galenweld/smart-bag/poster/seal.png

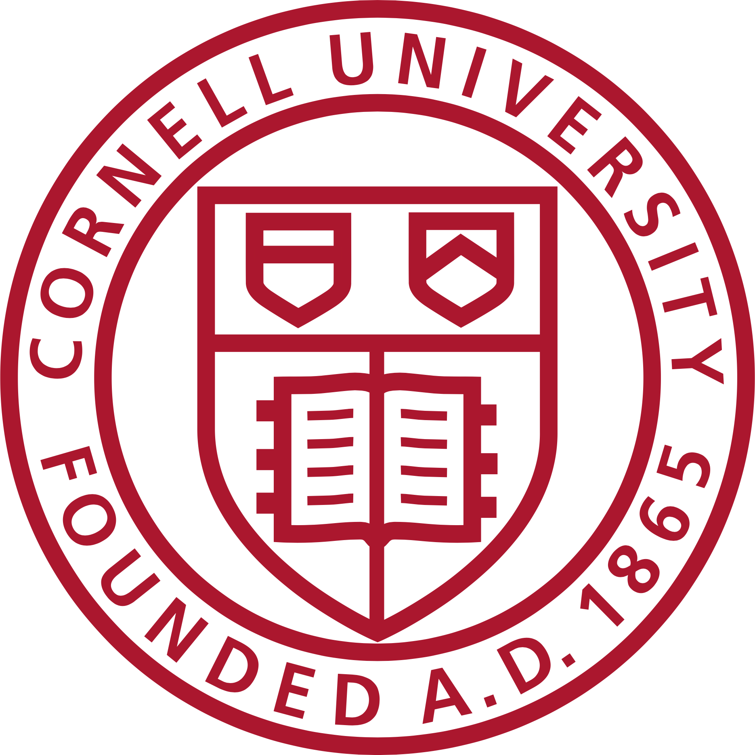
poster/seal.png
