galenweld/smart-bag/writeup/lcd.jpg

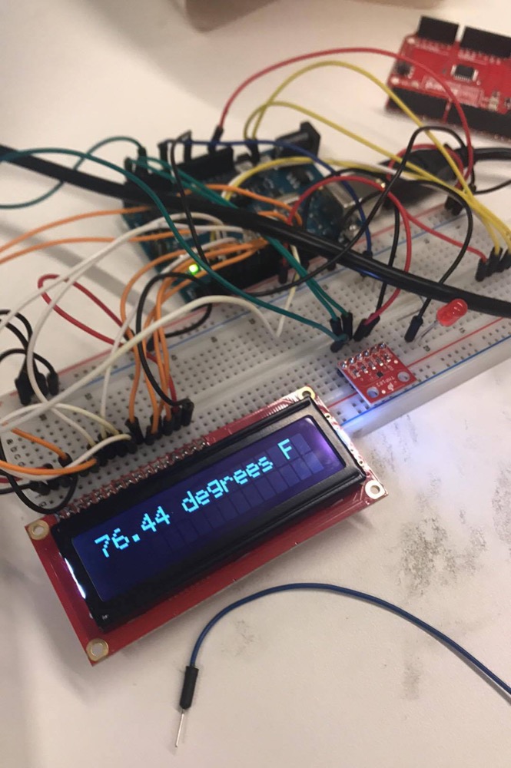
writeup/lcd.jpg
