galenweld/smart-bag/writeup/wiring.jpg

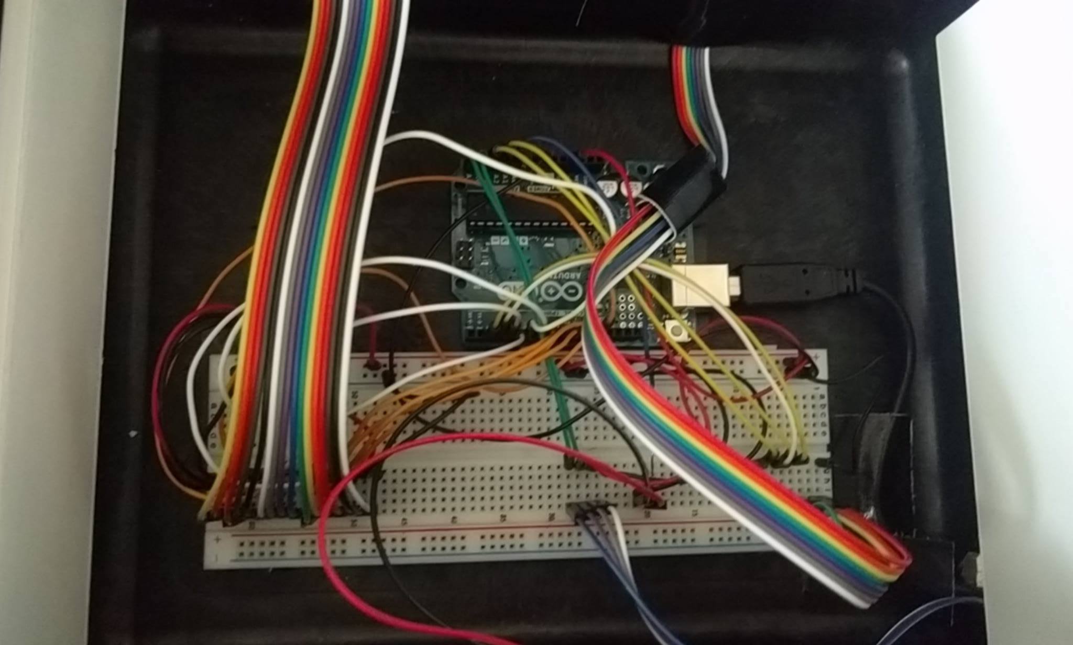
writeup/wiring.jpg
