galenweld/smart-bag/write_tags/write_tags.ino

#include <Adafruit_PN532.h>

/**************************************************************************/
/*! 
Writes NFC information to represent a medication to a card.
Data is written to the first block of sector 1.
The relevant information is stored in the first three spots of the block,
in the following order:

MEDICATION
0 - Albuterol
1 - Aspirin
2 - Epinepherine
3 - Glucose

EXPIRATION
A single value 0..99 representing the expiration date.

VALID
0 for valid
1 for expired
2 for temp

For example 02:15:00 would represent a EpiPen expiring at 15 that is valid.

*/
/**************************************************************************/
#include <Wire.h>
#include <SPI.h>
#include <Adafruit_PN532.h>
#define PN532_SCK  (2)
#define PN532_MOSI (3)
#define PN532_SS   (4)
#define PN532_MISO (5)
#define PN532_IRQ   (2)
#define PN532_RESET (3)  // Not connected by default on the NFC Shield



// Definitions to make code more readable
#define ALB (0)  // albuterol
#define ASA (1)  // aspirin
#define EPI (2)  // epinepherine
#define GLC (3)  // glucose

#define NOM (0)  // medication is normal
#define EXP (1)  // medication is expired
#define HOT (2)  // medication has exceeded environmental constraints

#define MED_TYPE   (0) // medication type
#define MED_EXP    (1) // medication expiration date
#define MED_STATUS (2) // medication status

// Use this line for a breakout with a software SPI connection (recommended):
Adafruit_PN532 nfc(PN532_SCK, PN532_MISO, PN532_MOSI, PN532_SS);

/**************************************************************************/
/* Enter Data to Write Below:
/**************************************************************************/
const uint8_t med[] = { ASA, 2, 0, 0, 0, 0, 0, 0, 0, 0, 0, 0, 0, 0, 0, 0 };

void setup(void) {
  Serial.begin(9600);
  Serial.println("Hello!");

  nfc.begin();

  uint32_t versiondata = nfc.getFirmwareVersion();
  if (! versiondata) {
    Serial.print("Didn't find PN53x board");
    while (1); // halt
  }
  // Got ok data, print it out!
  Serial.print("Found chip PN5"); Serial.println((versiondata>>24) & 0xFF, HEX); 
  Serial.print("Firmware ver. "); Serial.print((versiondata>>16) & 0xFF, DEC); 
  Serial.print('.'); Serial.println((versiondata>>8) & 0xFF, DEC);
  
  // configure board to read RFID tags
  nfc.SAMConfig();
  
  Serial.println("Waiting for an ISO14443A Card ...");
}


void loop(void) {
  uint8_t success;
  uint8_t uid[] = { 0, 0, 0, 0, 0, 0, 0 };  // Buffer to store the returned UID
  uint8_t uidLength;                        // Length of the UID (4 or 7 bytes depending on ISO14443A card type)
    
  // Wait for an ISO14443A type cards (Mifare, etc.).  When one is found
  // 'uid' will be populated with the UID, and uidLength will indicate
  // if the uid is 4 bytes (Mifare Classic) or 7 bytes (Mifare Ultralight)
  success = nfc.readPassiveTargetID(PN532_MIFARE_ISO14443A, uid, &uidLength);
  
  if (success) {
    // Display some basic information about the card
    Serial.println("Found an ISO14443A card");
    Serial.print("  UID Length: ");Serial.print(uidLength, DEC);Serial.println(" bytes");
    Serial.print("  UID Value: ");
    nfc.PrintHex(uid, uidLength);
    Serial.println("");
    
    if (uidLength == 4)
    {
      // We probably have a Mifare Classic card ... 
      Serial.println("Seems to be a Mifare Classic card (4 byte UID)");
    
      // Now we need to try to authenticate it for read/write access
      // Try with the factory default KeyA: 0xFF 0xFF 0xFF 0xFF 0xFF 0xFF
      Serial.println("Trying to authenticate block 4 with default KEYA value");
      uint8_t keya[6] = { 0xFF, 0xFF, 0xFF, 0xFF, 0xFF, 0xFF };
    
    // Start with block 4 (the first block of sector 1) since sector 0
    // contains the manufacturer data and it's probably better just
    // to leave it alone unless you know what you're doing
      success = nfc.mifareclassic_AuthenticateBlock(uid, uidLength, 4, 0, keya);
    
      if (success)
      {
        Serial.println("Sector 1 (Blocks 4..7) has been authenticated");
        uint8_t data[16];
    
        // If you want to write something to block 4 to test with, uncomment
        // the following line and this text should be read back in a minute
        memcpy(data, med, sizeof data);
        success = nfc.mifareclassic_WriteDataBlock (4, data);

        // Try to read the contents of block 4
        success = nfc.mifareclassic_ReadDataBlock(4, data);
    
        if (success)
        {
          // Data seems to have been read ... spit it out
          Serial.println("Reading Block 4:");
          nfc.PrintHexChar(data, 16);
          Serial.println("");
      
          // Wait a bit before reading the card again
          delay(1000);
        }
        else
        {
          Serial.println("Ooops ... unable to read the requested block.  Try another key?");
        }
      }
      else
      {
        Serial.println("Ooops ... authentication failed: Try another key?");
      }
    }
    
    if (uidLength != 4)
    {
      Serial.println("Card UID of improper length error.");

    }
  }
}
