galenweld/smart-bag/rgb_led_test/rgb_led_test.ino

// NeoPixel Ring simple sketch (c) 2013 Shae Erisson
// released under the GPLv3 license to match the rest of the AdaFruit NeoPixel library

#include <Adafruit_NeoPixel.h>
#ifdef __AVR__
  #include <avr/power.h>
#endif

// Which pin on the Arduino is connected to the NeoPixels?
// On a Trinket or Gemma we suggest changing this to 1
#define PIN 6

// How many NeoPixels are attached to the Arduino?
#define NUMPIXELS 8

// When we setup the NeoPixel library, we tell it how many pixels, and which pin to use to send signals.
// Note that for older NeoPixel strips you might need to change the third parameter--see the strandtest
// example for more information on possible values.
Adafruit_NeoPixel pixels = Adafruit_NeoPixel(NUMPIXELS, PIN, NEO_GRB + NEO_KHZ800);

int delayval = 500; // delay for half a second

void setup() {
  pixels.begin(); // This initializes the NeoPixel library.
}

void loop() {

  // For a set of NeoPixels the first NeoPixel is 0, second is 1, all the way up to the count of pixels minus one.
  
  // pixels.Color takes RGB values, from 0,0,0 up to 255,255,255

  //red
  pixels.setPixelColor(0, pixels.Color(255,0,0));
  //orange
  pixels.setPixelColor(1, pixels.Color(255,165,0));
  //yellow
  pixels.setPixelColor(2, pixels.Color(255,255,0));
  //green
  pixels.setPixelColor(3, pixels.Color(0,128,0));
  //blue
  pixels.setPixelColor(4, pixels.Color(0,0,255));
  //indigo
  pixels.setPixelColor(5, pixels.Color(75,0,130));
  //violet
  pixels.setPixelColor(6, pixels.Color(128,0,128));
}
