galenweld/smart-bag/(commit log)

2017-04-25 added arduino test file for rfid breakout board
2017-04-30 Test for temp sensor
2017-05-01 Added support for regular LED
2017-05-02 Got temperature sensor working and code included here
2017-05-03 Added test interfacing lcd display and temp sensor
2017-05-04 added new file for prototype
2017-05-04 added a file which simply resets the valid bit of a med without editing anything else
    [reset_med.ino]
2017-05-04 everything works great except for the totally strange bug that's incrementing by array without me trying to...
    [serial_prototype.ino]
2017-05-04 started working on final prototype
2017-05-04 reworked reset_med to work with new pins without serial
    [lcd_prototype.ino, reset_med.ino]
